Kozucjusz/LED_DIGITAL_DRIVER/Schematics/LED_DIGITAL_DRIVER_SCH.pdf

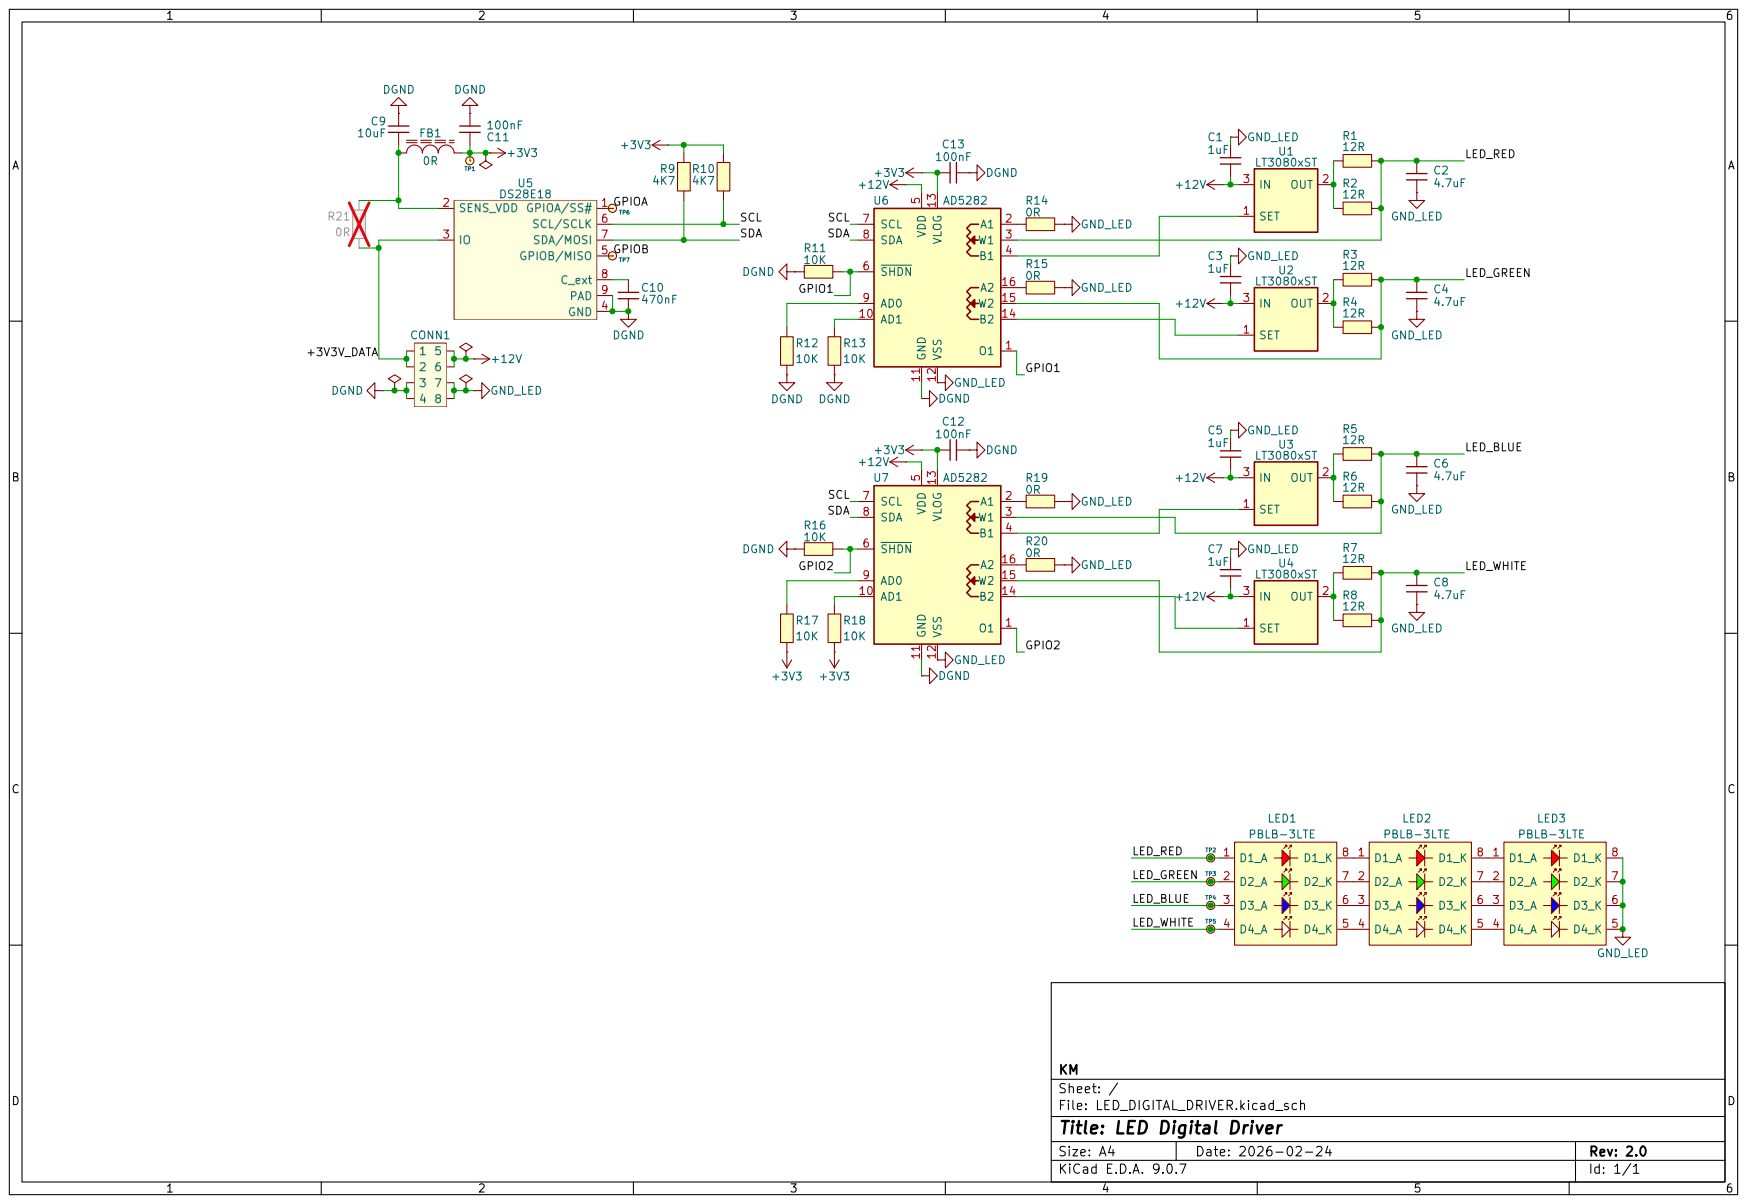
[picture p5: page 1]
