Kozucjusz/LED_DIGITAL_DRIVER/LED_DIGITAL_DRIVER.ioc

Mcu.UserName=STM32G431RBTx
PA13.GPIO_Label=T_SWDIO
PA13.Signal=SYS_JTMS-SWDIO
PA14.GPIO_Label=T_SWCLK
PA14.Signal=SYS_JTCK-SWCLK
PA2.Signal=LPUART1_TX
PA3.Signal=LPUART1_RX
PB3.GPIO_Label=T_SWO
PB3.Signal=SYS_JTDO-SWO
PC14-OSC32_IN.GPIO_Label=RCC_OSC32_OUT
PC14-OSC32_IN.Signal=RCC_OSC32_IN
PC15-OSC32_OUT.GPIO_Label=RCC_OSC32_OUT
PC15-OSC32_OUT.Signal=RCC_OSC32_OUT
PC4.Signal=USART1_TX
PC5.Signal=GPIO_Output
PF0-OSC_IN.GPIO_Label=RCC_OSC_IN
PF0-OSC_IN.Signal=RCC_OSC_IN
PF1-OSC_OUT.GPIO_Label=RCC_OSC_OUT
PF1-OSC_OUT.Signal=RCC_OSC_OUT
